algyan/algyan_6th/readme.md

# ALGYAN 6th
  This Repository is "IoT ALGYAN 6th" event novelty board info.

  Top  
  |  
  +- board_info : board design information (ex.gerber data, schematics etc.)  
  |  
  +- Howto_Soldering : Instructions for soldering parts  
  |  
  +- HwTestApps :
