algyan/algyan_6th/Howto_Soldering/img/D1b.png

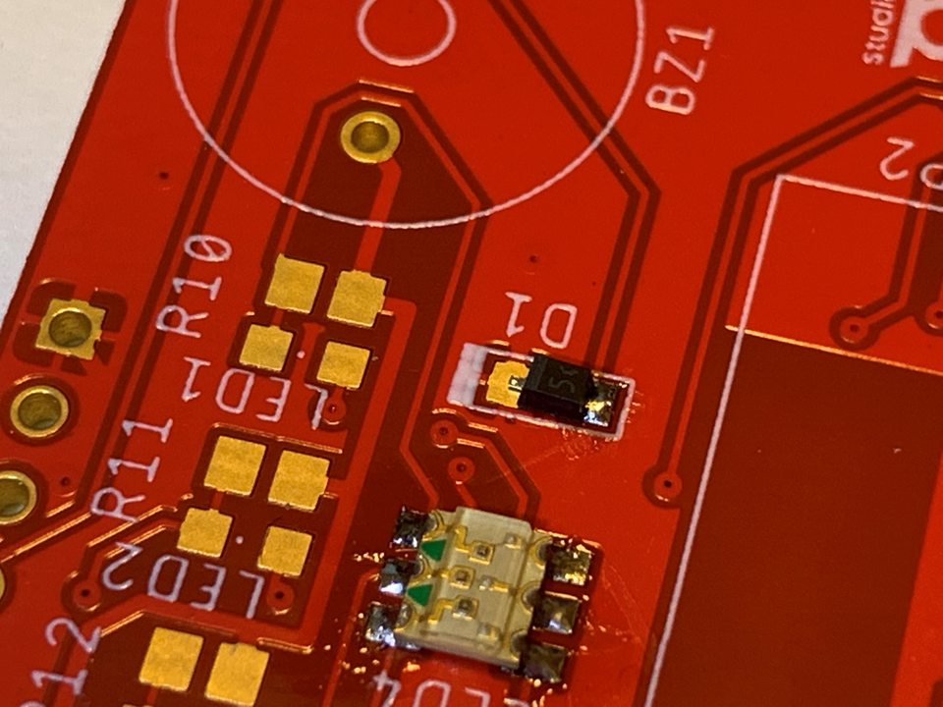
Howto_Soldering/img/D1b.png
