algyan/algyan_6th/(threads)

Thread 1 (2021-06-07):

Arduino IDEから自動書き込み時のリトライ／タイムアウトの件

pokibon3, 2021-06-07:
素敵な基板を提供いただきありがとうございます。
6th基板から「ESP32 自動書き込み」がサポートされましたが、自分の環境（Windows10、M1 Mac）だと結構な確率でリトライ、タイムアウトになります。ボタン操作で回避できるのですが。。。
ENのコンデンサ(C7)が0.01uだと、BOOTがLOWになる前にENが立ち上がってしまうため、なかなかBOOTモードに移行しないようです。ESP32 DevkitC V4ではこのコンデンサが0.1uに変更されたようです。
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
CH1:BOOT、CH2:EN
