algyan/algyan_6th/Howto_Soldering/ALGYAN-6th_board_parts_list_setA.pdf

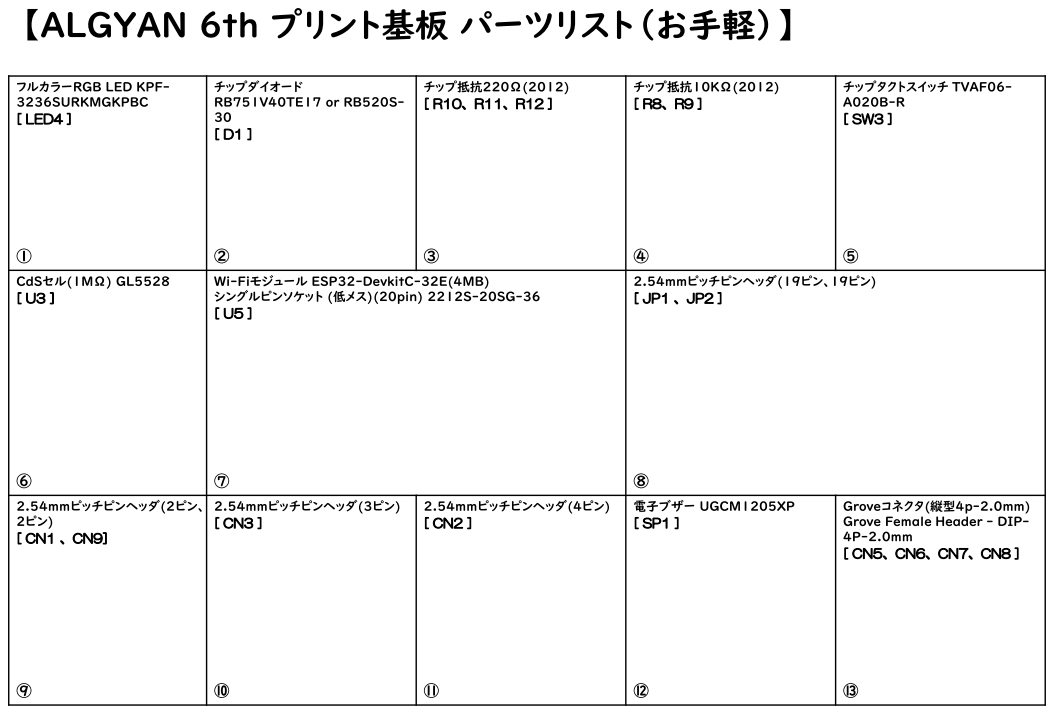
[picture p54: page 1]

[ LED4 ] | [ D1 ] | [ R10、R11、R12 ] | [ R8、R9 ] | [ SW3 ]
