algyan/algyan_6th/Howto_Soldering/ALGYAN-6th_board_parts_list_setB.pdf

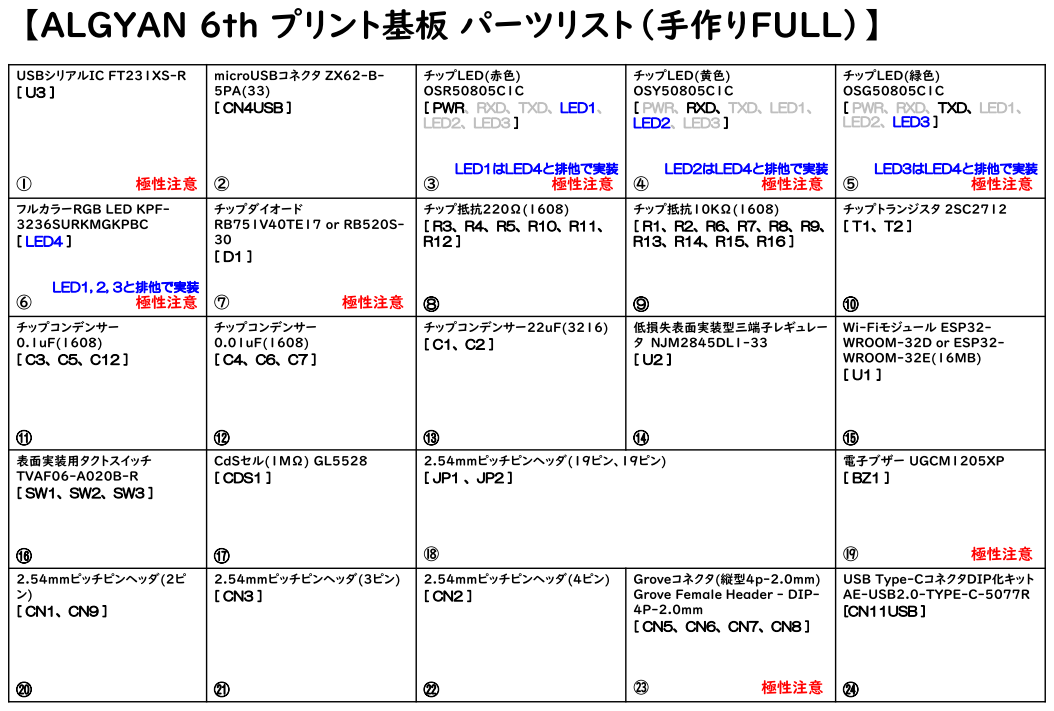
[picture p55: page 1]

[ U3 ] | [ CN4USB ] | [ PWR、RXD、TXD、LED1、 LED2、LED3 ] LED1はLED4と排他で実装 | [ PWR、RXD、TXD、LED1、 LED2、LED3 ] LED2はLED4と排他で実装 | [ PWR、RXD、TXD、LED1、 LED2、LED3 ] LED3はLED4と排他で実装

[ LED4 ] LED1, 2, 3と排他で実装 | [ D1 ] | [ R3、R4、R5、R10、R11、 R12 ] ⑧ | [ R1、R2、R6、R7、R8、R9、 R13、R14、R15、R16 ] ⑨ | [ T1、T2 ] ⑩

[ SW1、SW2、SW3 ] ⑯ | [ CDS1 ] ⑰ | [ JP1 、JP2 ] | | [ BZ1 ]

[ CN1、CN9 ] ⑳ | [ CN3 ] ㉑ | [ CN2 ] ㉒ | [ CN5、CN6、CN7、CN8 ] | [CN11USB ] ㉔
