algyan/algyan_6th/board_Info/algyan-6th-03.pdf

# GND RB⁷⁵¹S ⁺³V³

# GND KPF⁻3236SURKMGKPBC

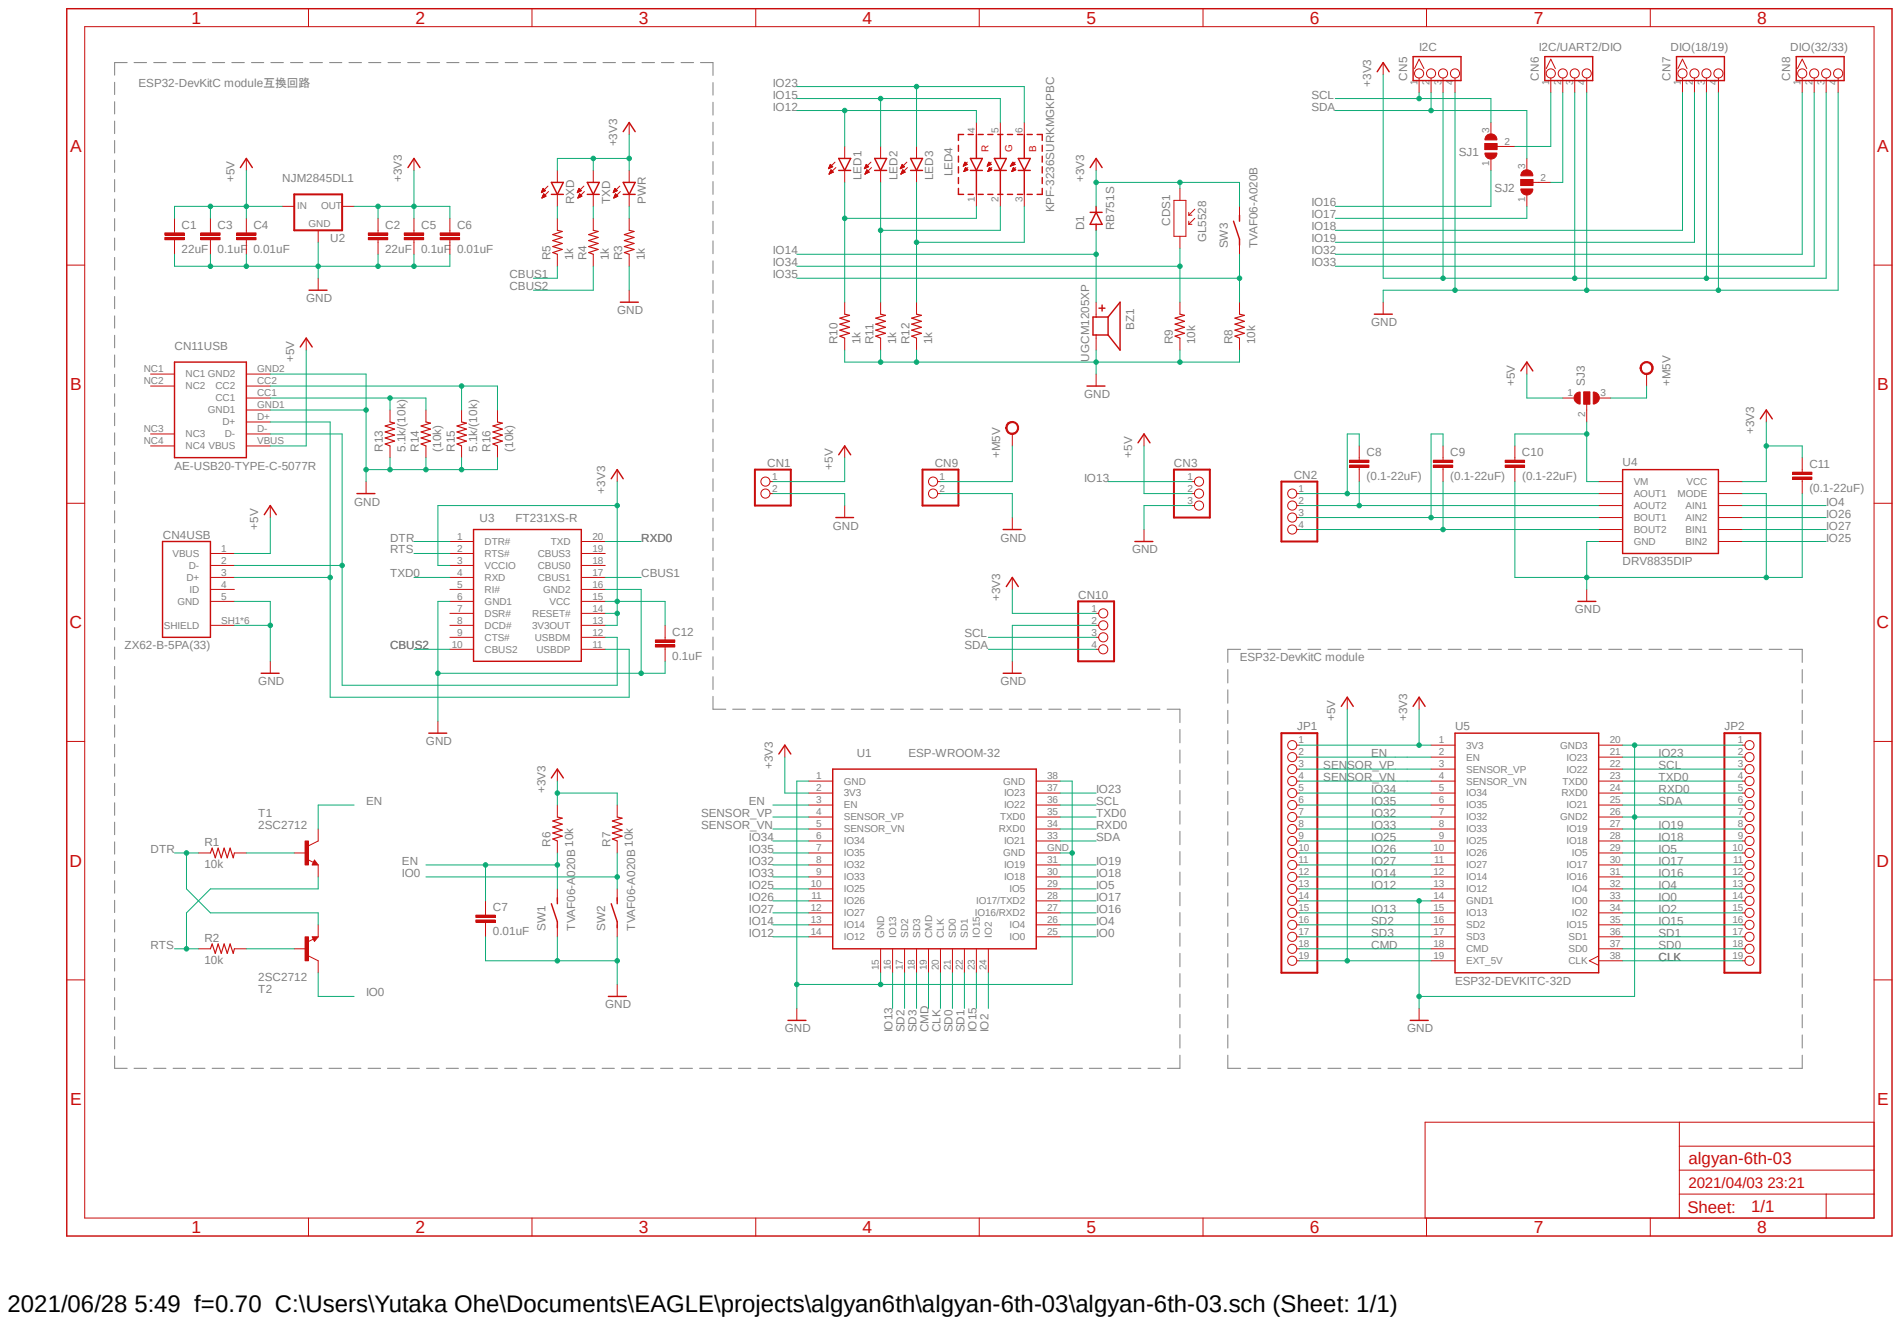
[picture p56: page 1]

2021/06/28 5:49 f=0.70 C:\Users\Yutaka Ohe\Documents\EAGLE\projects\algyan6th\algyan-6th-03\algyan-6th-03.sch (Sheet: 1/1)
