algyan/algyan_6th/(commit log)

2021-06-30 add board_info, Howto_Solderring(Chapter of preperation)
    [algyan-6th-03.brd, algyan-6th-03.sch]
2021-07-03 Update Howto Soldering
